nonolith/CEE/eagle/cee.brd.png

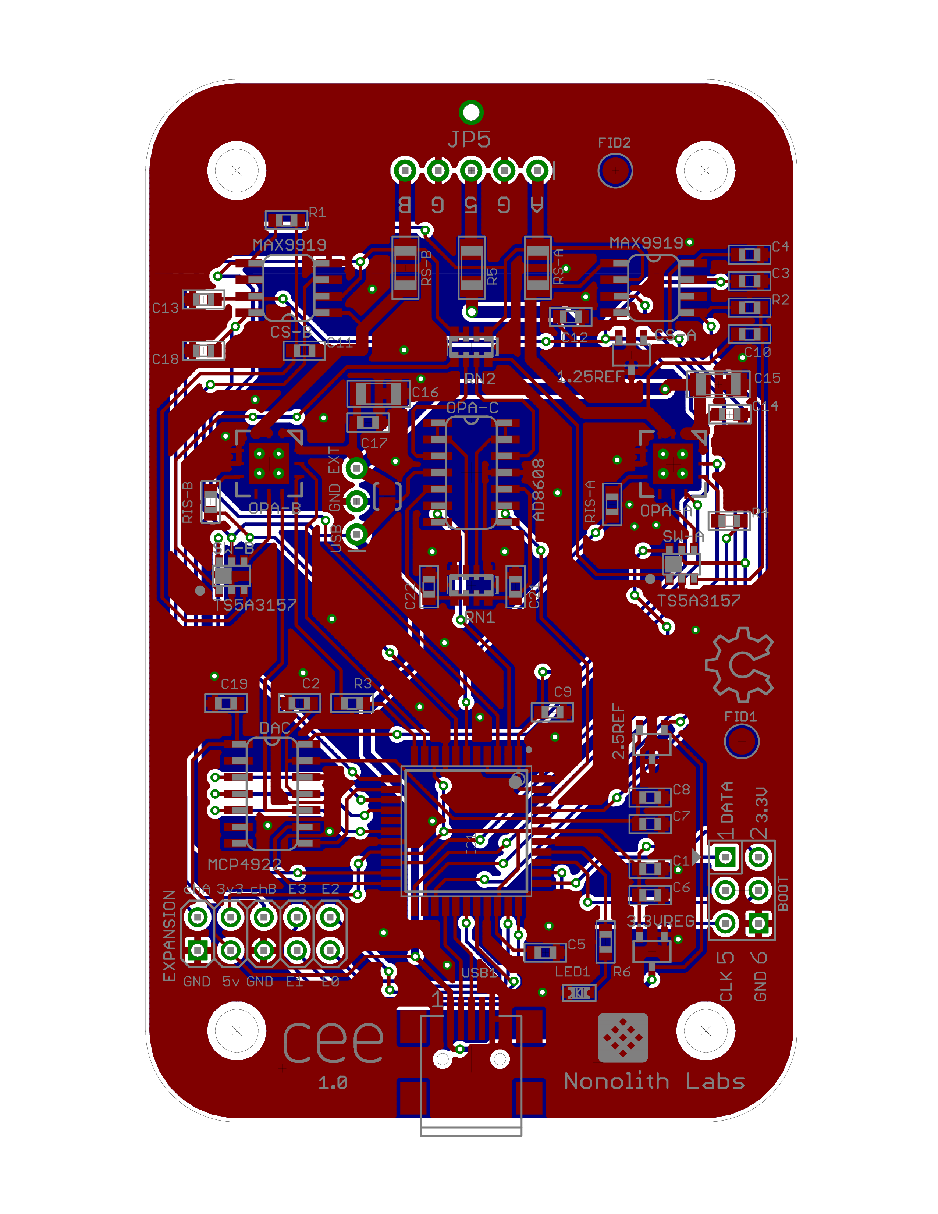
eagle/cee.brd.png
