nonolith/CEE/eagle/cee.sch.png

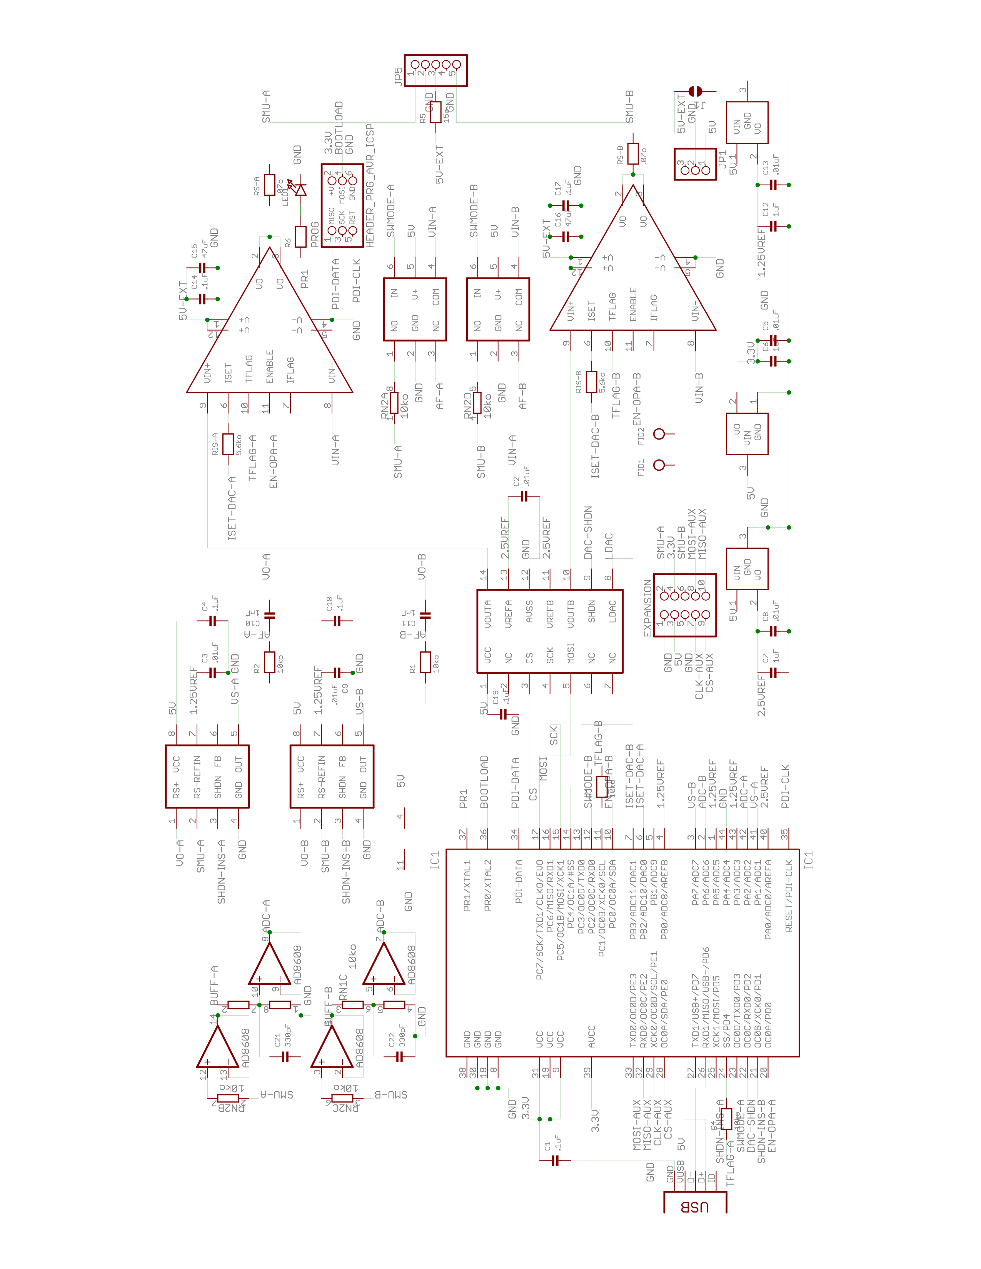
eagle/cee.sch.png
