nonolith/CEE/eagle/cee.brd.pdf

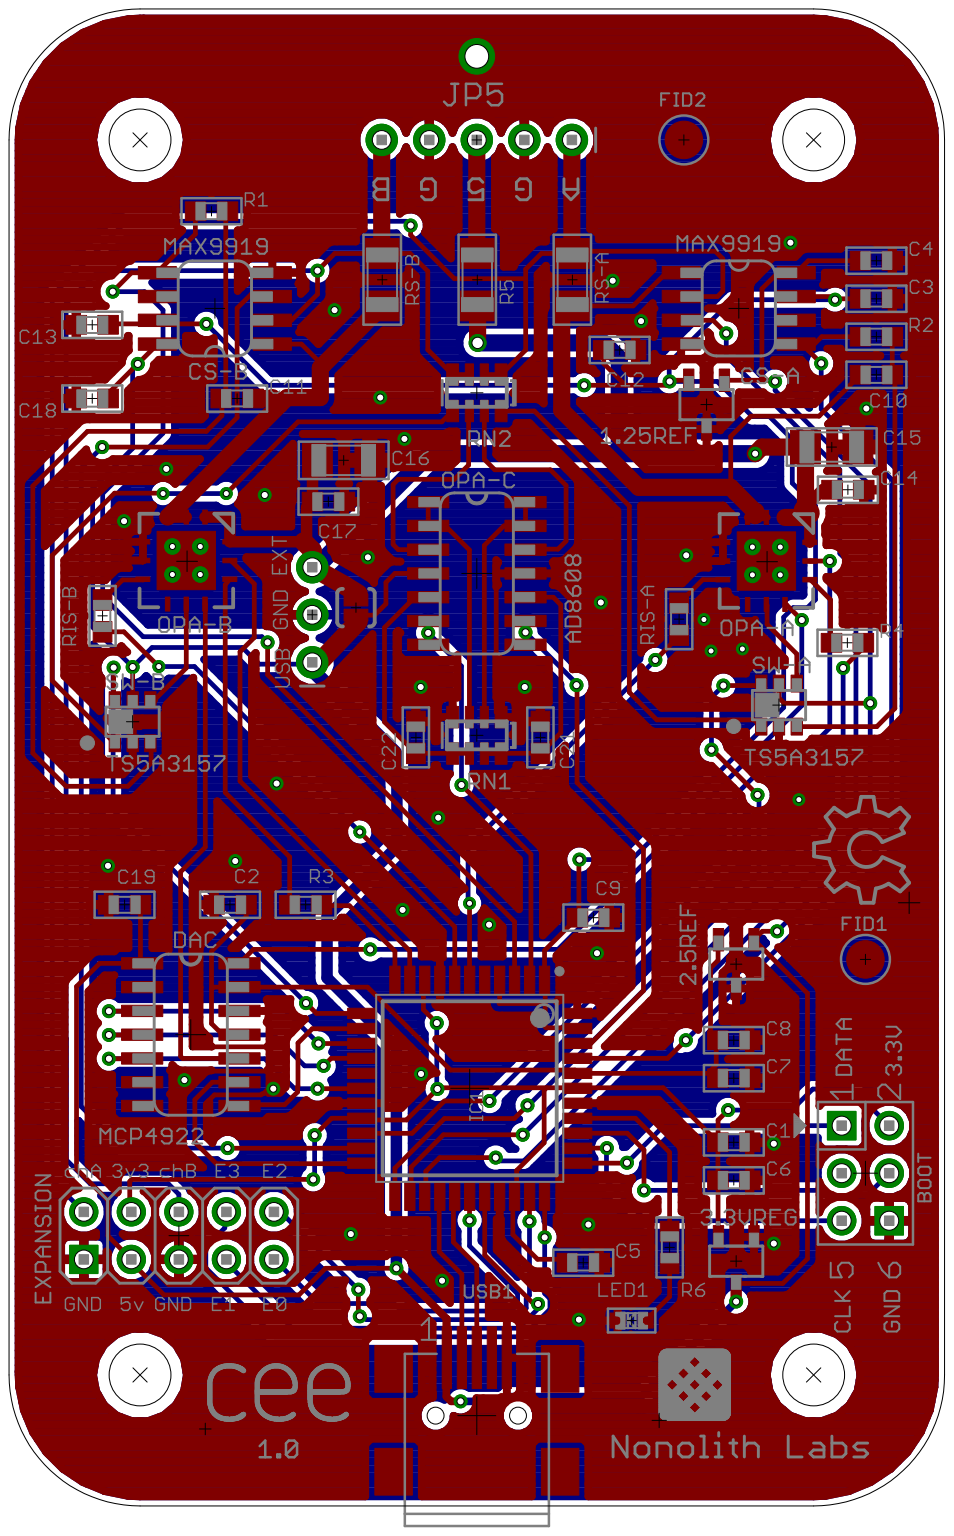
[picture p3: page 1]
