nonolith/CEE/eagle/cee.sch.pdf

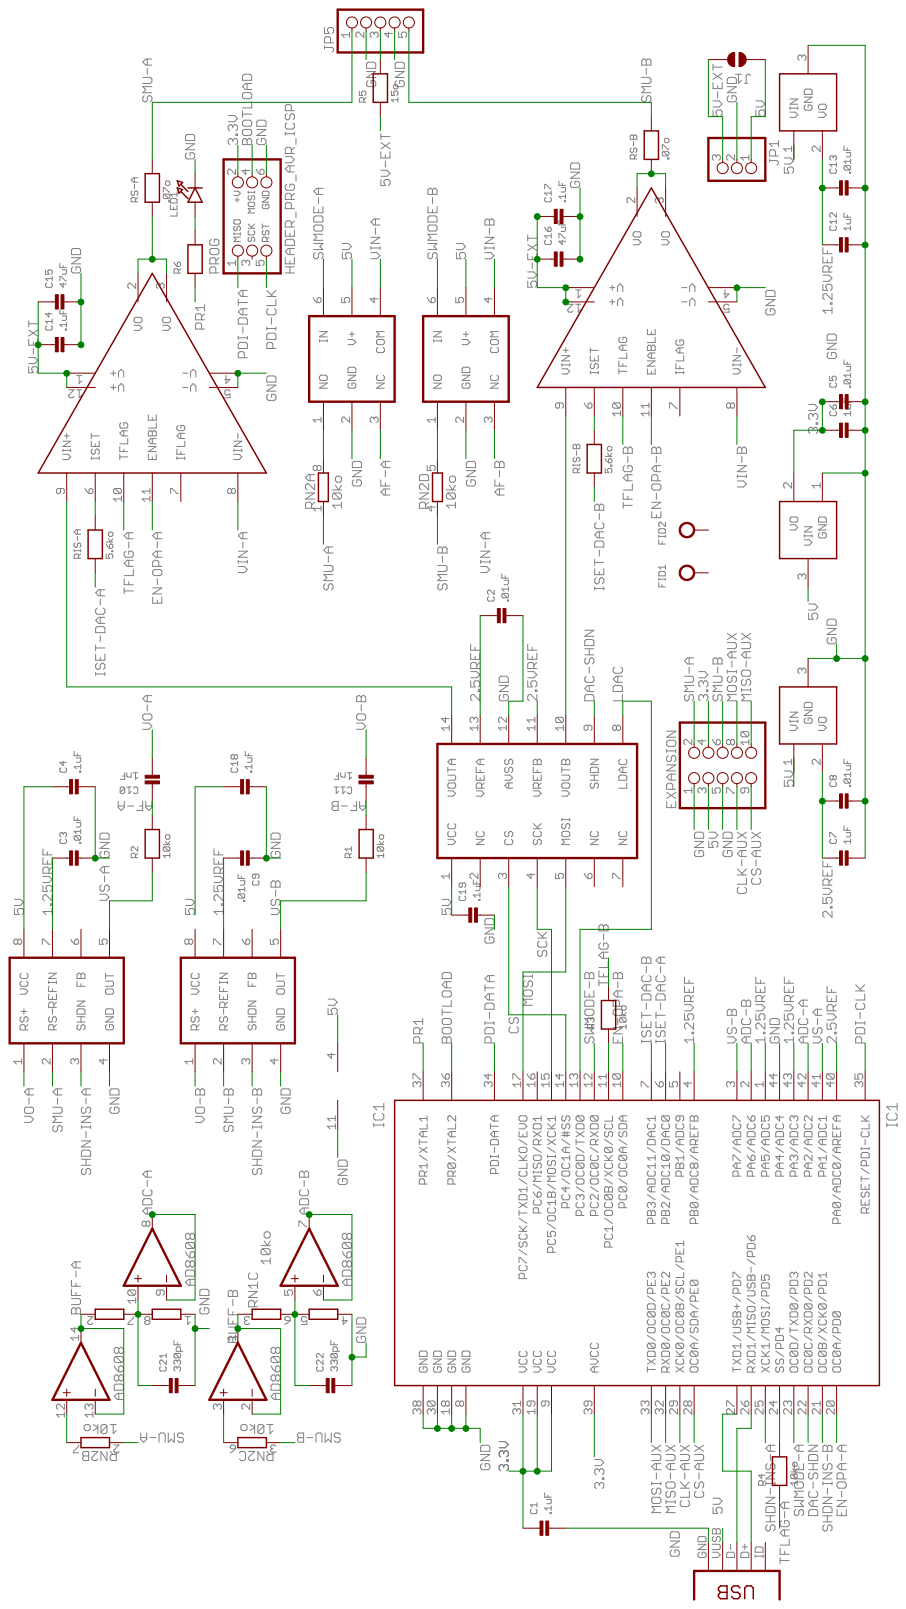
[picture p4: page 1]
