nonolith/CEE/eagle/cee.brd

## EAGLE design eagle/cee.brd (2013-06-05)

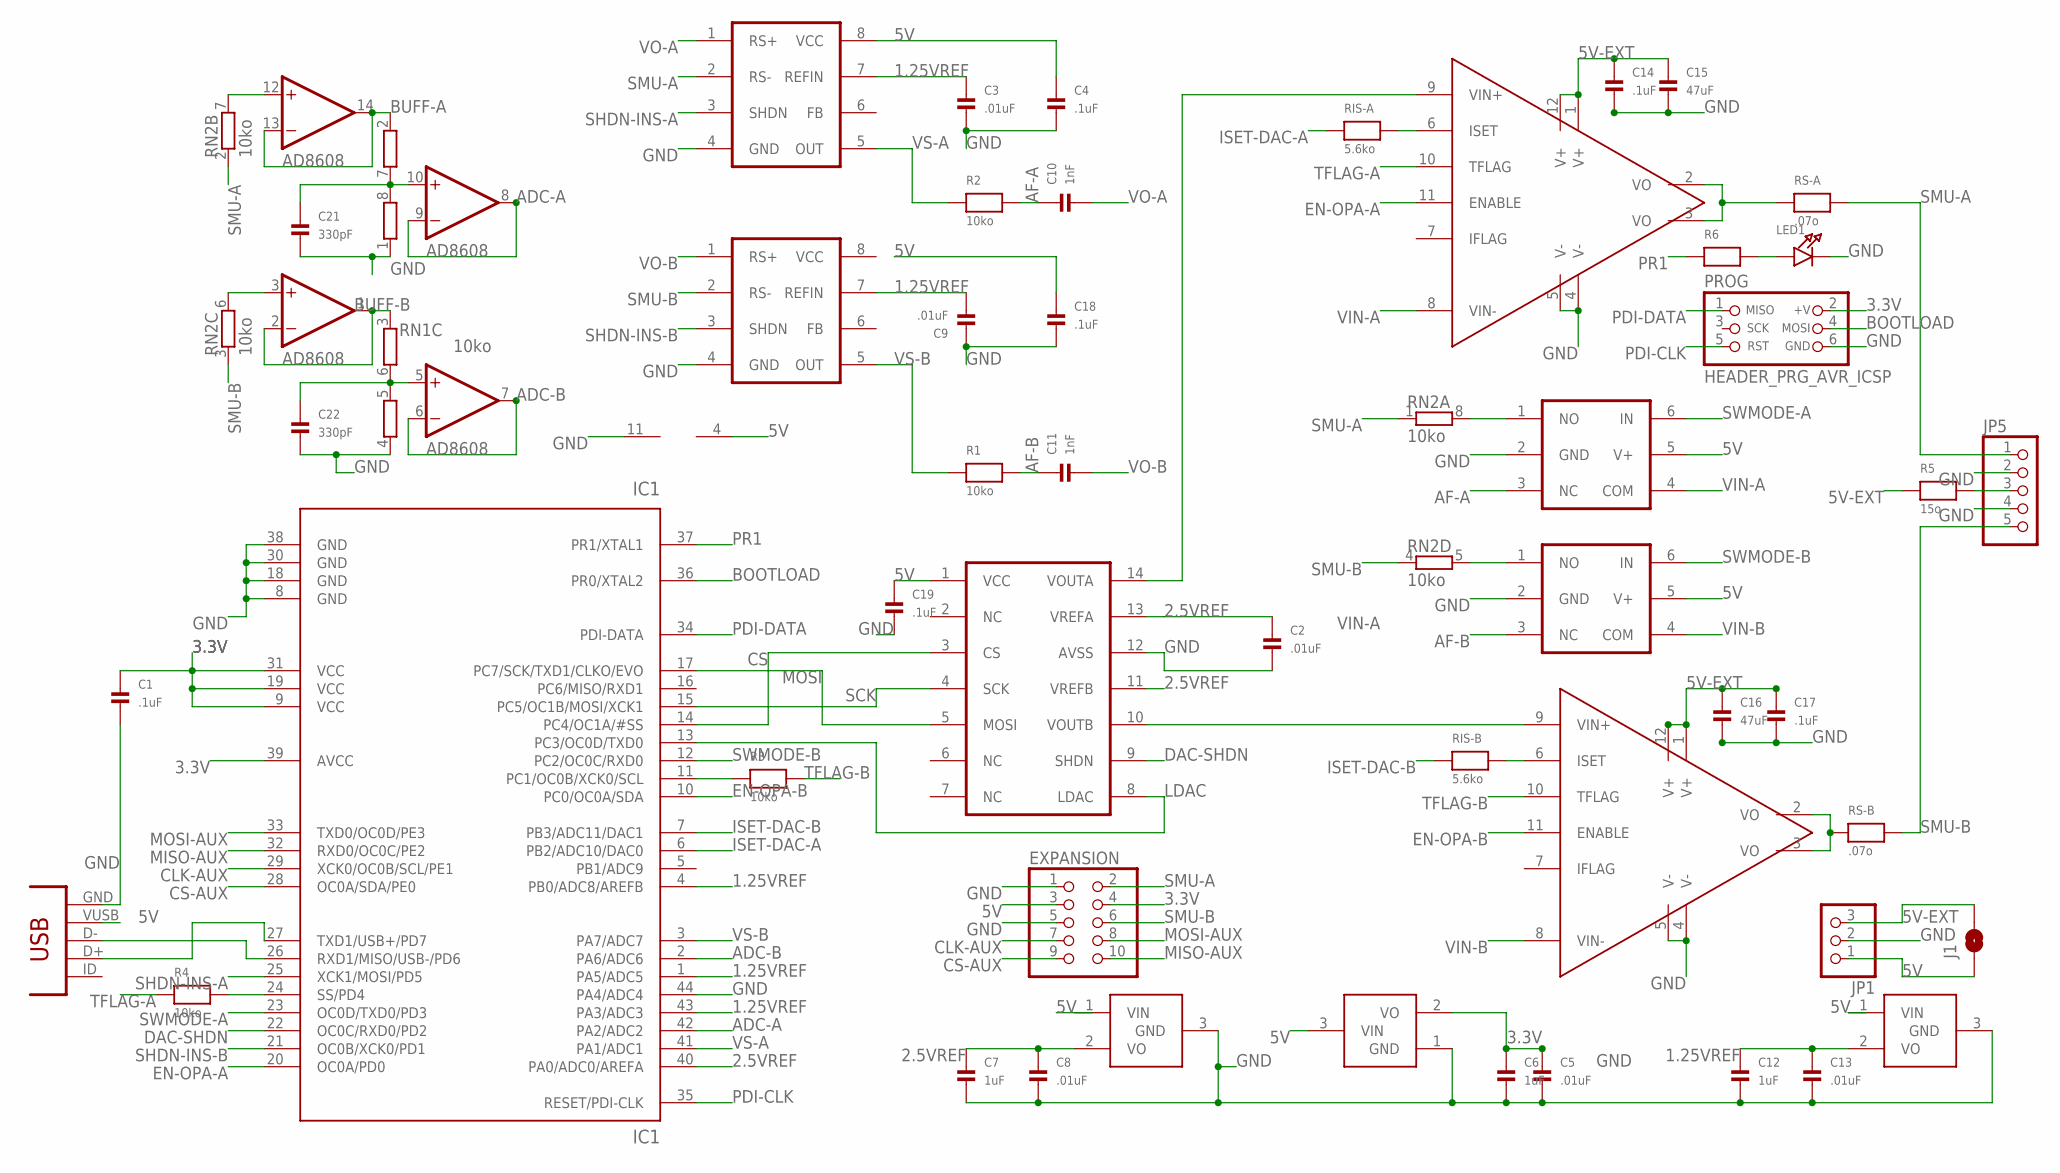
[picture p5: schematic cee.sch]

Parts:
1.25REF, 2.5REF: VREF; SOT23-3
3.3VREG: VREG; SOT23-3
C1, C4, C14, C17, C18, C19: .1uF; 0603
C2, C3, C5, C8, C9, C13: .01uF; 0603
C6, C7, C12: 1uF; 0603
C10, C11: 1nF; 0603
C15, C16: 47uF; 1206
C21, C22: 330pF; 0603
CS-A: MAX9919; SO-08
CS-B: MAX9919; SO-08
DAC: MCP4922; SO-14
EXPANSION: HEADER-2X5; 2X05
IC1: IC1; TQFP-44
J1: SOLDERJUMPERNC2; SJ_2S-NOTRACE
JP1: HEADER-1X3ROUND; 1X03_ROUND
JP5: HEADER-1X5ROUND; 1X05_ROUND
LED1: LED0603; CHIPLED_0603
OPA-A: OPA567; QFN-12
OPA-B: OPA567; QFN-12
OPA-C: AD8608; SO-14
PROG: HEADER_PRG_AVR_ICSP; HEADER_PRG_2X03
R1, R2, R3, R4: 10ko; 0603
R5: 15o; 1206
R6: RESISTOR0603; 0603
RIS-A: 5.6ko; 0603
RIS-B: 5.6ko; 0603
RN1, RN2: 10ko; RN8P-4R-CRA06S
RS-A: .07o; 1206
RS-B: .07o; 1206
SW-A: TS5A3157; SOT23-6
SW-B: TS5A3157; SOT23-6
USB1: CON-USB-MINI-BUSB1; CONN_USB_MINI-B

Connections:
1.25VREF: 1.25REF.2 (VO), C3.1, C9.2, C12.1, C13.1, CS-A.7 (REFIN), CS-B.7 (REFIN), IC1.1 (PA5/ADC5), IC1.4 (PB0/ADC8/AREFB), IC1.43 (PA3/ADC3)
2.5VREF: 2.5REF.2 (VO), C2.1, C7.1, C8.1, DAC.11 (VREFB), DAC.13 (VREFA), IC1.40 (PA0/ADC0/AREFA)
3.3V: 3.3VREG.2 (VO), C1.1, C5.1, C6.1, EXPANSION.4, IC1.9 (VCC), IC1.19 (VCC), IC1.31 (VCC), IC1.39 (AVCC), PROG.2 (+V)
5V: 1.25REF.1 (VIN), 2.5REF.1 (VIN), 3.3VREG.3 (VIN), C4.1, C18.1, C19.1, CS-A.8 (VCC), CS-B.8 (VCC), DAC.1 (VCC), EXPANSION.3, J1.1, JP1.1, OPA-C.4 (V+), SW-A.5 (V+), SW-B.5 (V+), USB1.VUSB
5V-EXT: C14.1, C15.1, C16.1, C17.1, J1.2, JP1.3, OPA-A.1 (V+), OPA-A.12 (V+), OPA-B.1 (V+), OPA-B.12 (V+), R5.1
5V-EXT-P: JP5.3, R5.2
ADC-A: IC1.42 (PA2/ADC2), OPA-C.8 (OUT), OPA-C.9 (-IN)
ADC-B: IC1.2 (PA6/ADC6), OPA-C.6 (-IN), OPA-C.7 (OUT)
AF-A: C10.1, R2.2, SW-A.3 (NC)
AF-B: C11.1, R1.2, SW-B.3 (NC)
BOOTLOAD: IC1.36 (PR0/XTAL2), PROG.4 (MOSI)
BUFF-A: OPA-C.13 (-IN), OPA-C.14 (OUT), RN1.2 (1)
BUFF-B: OPA-C.1 (OUT), OPA-C.2 (-IN), RN1.3 (1)
CLK-AUX: EXPANSION.7, IC1.29 (XCK0/OC0B/SCL/PE1)
CS: DAC.3 (CS), IC1.14 (PC4/OC1A/#SS)
CS-AUX: EXPANSION.9, IC1.28 (OC0A/SDA/PE0)
D+: IC1.27 (TXD1/USB+/PD7), USB1.D+
D-: IC1.26 (RXD1/MISO/USB-/PD6), USB1.D-
DAC-SHDN: DAC.9 (SHDN), IC1.22 (OC0C/RXD0/PD2)
EN-OPA-A: IC1.20 (OC0A/PD0), OPA-A.11 (ENABLE)
EN-OPA-B: IC1.10 (PC0/OC0A/SDA), OPA-B.11 (ENABLE)
GND: 1.25REF.3 (GND), 2.5REF.3 (GND), 3.3VREG.1 (GND), C1.2, C2.2, C3.2, C4.2, C5.2, C6.2, C7.2, C8.2, C9.1, C12.2, C13.2, C14.2, C15.2, C16.2, C17.2, C18.2, C19.2, C21.2, C22.2, CS-A.4 (GND), CS-B.4 (GND), DAC.12 (AVSS), EXPANSION.1, EXPANSION.5, IC1.8 (GND), IC1.18 (GND), IC1.30 (GND), IC1.38 (GND), IC1.44 (PA4/ADC4), JP1.2, JP5.2, JP5.4, LED1.C, OPA-A.4 (V-), OPA-A.5 (V-), OPA-B.4 (V-), OPA-B.5 (V-), OPA-C.11 (V-), PROG.6 (GND), RN1.1, RN1.4 (1), SW-A.2 (GND), SW-B.2 (GND), USB1.GND
ISET-A: OPA-A.6 (ISET), RIS-A.2
ISET-B: OPA-B.6 (ISET), RIS-B.2
ISET-DAC-A: IC1.6 (PB2/ADC10/DAC0), RIS-A.1
ISET-DAC-B: IC1.7 (PB3/ADC11/DAC1), RIS-B.1
LDAC: DAC.8 (LDAC), IC1.13 (PC3/OC0D/TXD0)
LEDR: LED1.A, R6.2
MISO-AUX: EXPANSION.10, IC1.32 (RXD0/OC0C/PE2)
MOSI: DAC.5 (MOSI), IC1.17 (PC7/SCK/TXD1/CLKO/EVO)
MOSI-AUX: EXPANSION.8, IC1.33 (TXD0/OC0D/PE3)
unnamed: C21.1, OPA-C.10 (+IN), RN1.7 (2), RN1.8 (2)
unnamed: C22.1, OPA-C.5 (+IN), RN1.5 (2), RN1.6 (2)
PDI-CLK: IC1.35 (RESET/PDI-CLK), PROG.5 (RST)
PDI-DATA: IC1.34 (PDI-DATA), PROG.1 (MISO)
PR1: IC1.37 (PR1/XTAL1), R6.1
SCK: DAC.4 (SCK), IC1.15 (PC5/OC1B/MOSI/XCK1)
SHDN-INS-A: CS-A.3 (SHDN), IC1.25 (XCK1/MOSI/PD5)
SHDN-INS-B: CS-B.3 (SHDN), IC1.21 (OC0B/XCK0/PD1)
SMU-A: CS-A.2 (RS-), EXPANSION.2, JP5.1, RN2.1, RN2.2 (1), RS-A.2
SMU-B: CS-B.2 (RS-), EXPANSION.6, JP5.5, RN2.3 (1), RN2.4 (1), RS-B.2
SMUP-A: OPA-C.12 (+IN), RN2.7 (2)
SMUP-B: OPA-C.3 (+IN), RN2.6 (2)
SMUP-SW-A: RN2.8 (2), SW-A.1 (NO)
SMUP-SW-B: RN2.5 (2), SW-B.1 (NO)
SWMODE-A: IC1.23 (OC0D/TXD0/PD3), SW-A.6 (IN)
SWMODE-B: IC1.12 (PC2/OC0C/RXD0), SW-B.6 (IN)
TFLAG-A: OPA-A.10 (TFLAG), R4.1
TFLAG-B: OPA-B.10 (TFLAG), R3.2
TFLAGP-A: IC1.24 (SS/PD4), R4.2
TFLAGP-B: IC1.11 (PC1/OC0B/XCK0/SCL), R3.1
VIN-A: OPA-A.8 (VIN-), SW-A.4 (COM)
VIN-B: OPA-B.8 (VIN-), SW-B.4 (COM)
VO-A: C10.2, CS-A.1 (RS+), OPA-A.2 (VO), OPA-A.3 (VO), RS-A.1
VO-B: C11.2, CS-B.1 (RS+), OPA-B.2 (VO), OPA-B.3 (VO), RS-B.1
VOUT-A: DAC.14 (VOUTA), OPA-A.9 (VIN+)
VOUT-B: DAC.10 (VOUTB), OPA-B.9 (VIN+)
VS-A: CS-A.5 (OUT), IC1.41 (PA1/ADC1), R2.1
VS-B: CS-B.5 (OUT), IC1.3 (PA7/ADC7), R1.1

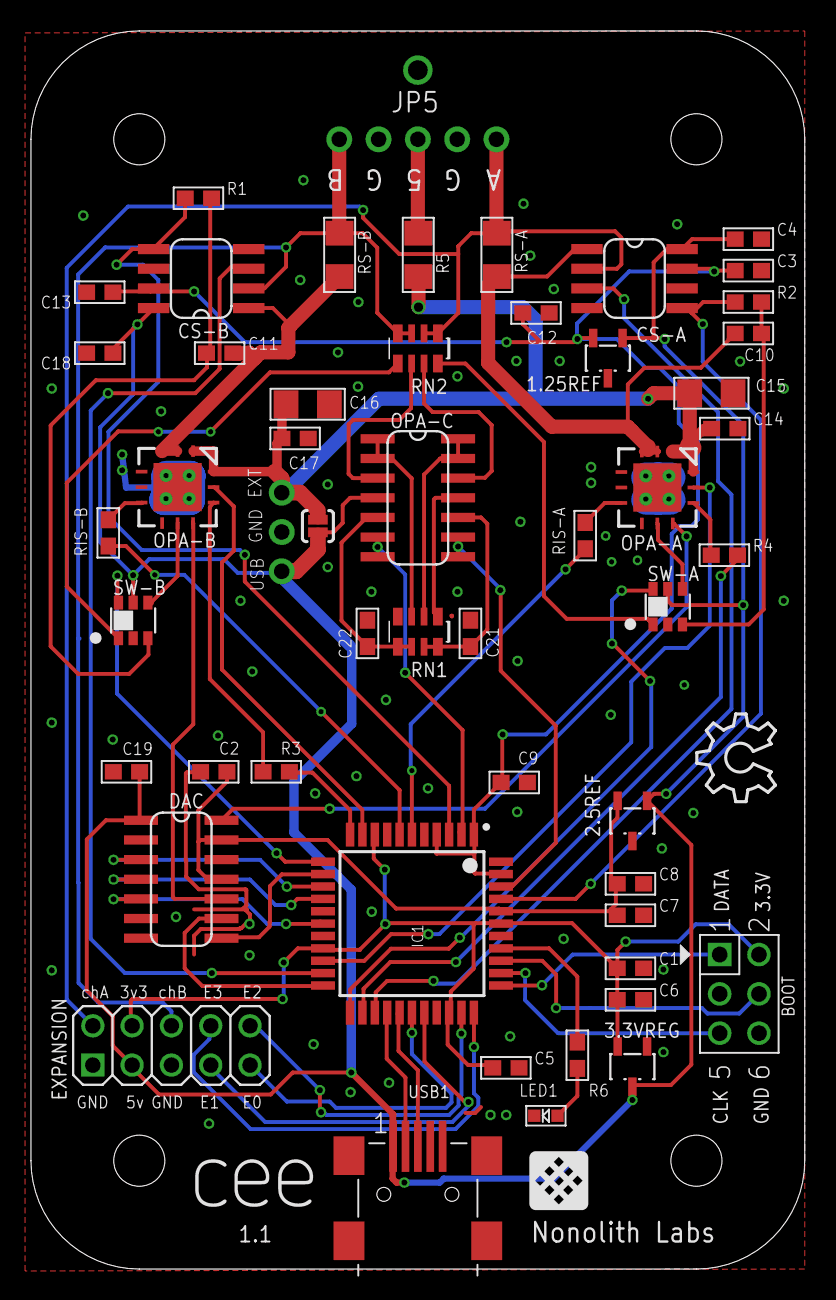
[picture p6: board cee.brd from above]

Board: 2 copper layers, 50.0 x 80.0 mm, 59 parts (0 on the bottom side), 59 nets.

Other parts of the board:
U$1: OSHW_8X200_NOTEXT
U$2: LOGO_CEE
U$3: LOGO_NONOLITH
U$8, U$9, U$10, U$11: STAND-OFF
