nonolith/CEE/(commit log)

2011-06-30 initial commit of eagle files for schematic test board
    [CEE-devboard.brd, CEE-devboard.sch]
2011-07-01 Add simplified schematic
2011-07-05 added BOM, exported from google docs.
2011-07-06 reformatted git repository, added pre-alpha EAGLE files for fully integrated board
    [devCEE.brd, devCEE.sch, integratedCEE.brd, integratedCEE.sch]
2011-07-10 added labels to all nets
    [devCEE.sch]
2011-07-19 extended pads on qfn12/opa567 by .2mm
2011-07-21 added rework of schematic featuring atxmega32a4u as primary micro. not yet complete, but all major chips are in place.
    [rehash.sch]
2011-07-21 more wires and netlabels. missing opamp buffer and vref
    [rehash.sch]
2011-07-21 decoupled, vref'ed, vcc'ed
    [rehash.sch]
2011-07-21 pretty close to done. opamp filter/adc buffers added, reference/regulator pinouts updated.
    [rehash.sch]
2011-07-22 removed old eagle files based on h-bridge switching and lpc1343
    [devCEE.brd, devCEE.sch, integratedCEE.brd, integratedCEE.sch]
2011-07-22 renamed rehash.sch to reflect relationship to bom
    [v3.sch]
2011-07-22 added iset resistors on opa-a and opa-b
    [v3.sch]
2011-07-22 added resistor values for RIS-A/B
    [v3.sch]
2011-07-22 added pdf. few small changes.
    [v3.sch]
2011-07-22 128 airwires to go...
    [v3.brd, v3.sch]
2011-07-25 added resistor values for INA2332 gainset
    [v3.sch]
2011-07-26 reworked wires, leaving vrefb open
    [v3.brd, v3.sch]
2011-07-29 replaced INA2332 with dual MAX9919/20
    [v3.brd, v3.sch]
2011-07-29 added ad8606 2chan opamp, reworked schem to reflect recent part decisions
    [v3.brd, v3.sch]
2011-07-29 oops, had an extra 2.5VREF instead of a 1.25VREF
    [v3.brd, v3.sch]
2011-07-29 added power connections to AD8606.
    [v3.brd, v3.sch]
2011-07-29 Rearrange ADC inputs for optimal use of XMEGA PGA
    [v3.brd, v3.sch]
2011-07-29 update simplified schematic
2011-07-29 Add protection resistors
    [v3.brd, v3.sch]
2011-07-29 removed BOM.pdf in favor of bit.ly/CEEBOM
2011-07-29 reworked DAC SPI connection to avoid potential RXD/CS conflict
    [v3.brd, v3.sch]
2011-07-29 added link to BOM in readme.mkd
2011-08-01 Board boundaries and mounting holes
    [v3.brd, v3.sch]
2011-08-03 placed passives, added arrays, reduced size
    [v3.brd, v3.sch]
2011-08-03 Ground fill
    [v3.brd]
2011-08-07 more layout, rm'ed gainset from max9919
    [v3.brd, v3.sch]
2011-08-07 Rearrange components for better routing
    [v3.brd, v3.sch]
2011-08-07 Start routing
    [v3.brd, v3.sch]
2011-08-07 more routing
    [v3.brd, v3.sch]
2011-08-07 added TS5A3157; single SPDT switch in SOT23
2011-08-07 replaced dual SPDT switch with a pair of single SPDT switches, increasing ease of routing.
    [v3.brd, v3.sch]
2011-08-07 GND and 5V routes
    [v3.brd]
2011-08-08 Routed + DRC pass
    [v3.brd]
2011-08-08 optimizations and extra caps on the opa567
    [v3.brd, v3.sch]
2011-08-08 Adjust ground planes
    [v3.brd, v3.sch]
2011-08-08 rehashed silkscreens, made a few random changes, added up-to-date images for brd and sch
    [v3.brd, v3.sch]
2011-08-08 Add to silkscreen, update board images
    [v3.brd, v3.sch]
2011-08-08 12mil ground plane clearance, tented vias
    [v3.brd]
2011-08-09 Header positioning; via tweaks
    [v3.brd]
2011-08-09 sync board to lib
    [v3.brd, v3.sch]
2011-08-09 Rework pins for better layout
    [v3.brd]
2011-08-09 Improve ground plane
    [v3.brd, v3.sch]
2011-08-09 DRC fix
    [v3.brd]
2011-08-09 grounding tweaks
    [v3.brd]
2011-08-10 1.25VREF to REFB
    [v3.brd, v3.sch]
2011-08-10 Rearrange ADC pins for more flexibility in ADC config
    [v3.brd, v3.sch]
2011-08-11 Clean up traces
    [v3.brd]
2011-08-12 fix 0-length airwire
    [v3.brd]
2011-08-12 8mil spacing, more OCD about trace angle
    [v3.brd]
2011-08-12 Split external 5V rail
    [v3.brd, v3.sch]
2011-08-12 Clean up silkscreen
    [v3.brd, v3.sch]
2011-08-12 MAX9919 decoupling caps
    [v3.brd, v3.sch]
2011-08-13 small board mods; increased trace spacing and width
    [v3.brd]
2011-08-13 increase 5v-EXT trace width
    [v3.brd]
2011-10-04 added correct function prototype for writeDAC
2011-10-05 calling it a night. DAC control is pretty much fail at the moment, but the pieces should be in place
    [vendorReqTest.py]
2011-10-06 Fix DAC SPI. - Configure 1MHz baud rate - Clear TX complete flag before using it - Mask and pack data correctly
2011-10-06 added channel config/write code based off schematic
2011-10-06 setting current/voltage is working! :D
2011-10-07 cleaned code, fixed iset function
    [vendorReqCtrl.py]
2011-10-08 sequential handling of ADCA.CH0 works - virtual channels were broken
    [vendorReqCtrl.py]
2011-10-08 Convert binary ADC data to V and A
2011-10-08 commented readADC to clarify pin/info mappings
2011-10-10 changed ADC to differential mode for great justice
2011-10-10 added offset removal function for better accuracy. switched ADC ground from external to internal for higher precision
2011-10-10 firmware/update.py: don't print error message when the device is already in bootloader mode
2011-10-12 replaced busyloop ADC code with dysfunctional freerun code
2011-10-13 fixed issues with schematic
    [v3.brd, v3.sch]
2011-10-14 changed DAC to SOIC
    [v3.brd, v3.sch]
2011-10-15 centered the package QFN12 and updated the v3.brd and v3.sch accordingly
    [v3.brd, v3.sch]
2011-10-16 reworked several traces - need to fix SMU-B to ADC-B and DAC routing. can't wait for vdiffs enabled via .brd/.sch as xml files...
    [v3.brd]
2011-10-16 Update library - split parts for VREG/VREF with correct pinouts for MCP1700/MAX6103. Update schematic to match
    [v3.brd, v3.sch]
2011-10-16 Route SOIC DAC
    [v3.brd]
2011-10-16 fully routed - extensive fixes of analog frontend and voltage regulators. TODO: silkscreen, DRC
    [v3.brd, v3.sch]
2011-10-17 made all decoupling capacitors horizontal for simple placement
    [v3.brd]
2011-10-17 added RC series circuit providing a higher-bw path in series with MAX9919
    [v3.brd, v3.sch]
2011-10-17 fixed DRC except for opa567 errors and 'drill size' errors.
    [v3.brd]
2011-10-17 Update current feedback filtering - resistor goes in series with feedback; route these areas more efficiently
    [v3.brd, v3.sch]
2011-10-17 Clean up minor zigzags in traces
    [v3.brd]
2011-10-17 Clean up traces and silkscreen
    [v3.brd]
2011-10-17 moved programming header from awkward five-pin to kosher six-pin (2x3)
    [v3.brd, v3.sch]
2011-10-17 updated board and library with [hopefully] visible silkscreen dot indicating switch orientation
    [v3.brd, v3.sch]
2011-10-17 added orientation indicator to SO-14, updated board accordingly
    [v3.brd, v3.sch]
2011-10-17 moved parts and polygons to have a 50 by 80 profile
    [v3.brd]
2011-10-18 added protection resistors on TFLAGs and on switch inputs
    [v3.brd, v3.sch]
2011-10-18 s/Nonolith Labs/NonolithLabs.com/ and added OSHW logo
    [v3.brd]
2011-10-19 Align traces, clean up. library: remove holes from USB footprint
    [v3.brd, v3.sch]
2011-10-19 Add decoupling caps on 5v rail for DAC and opamp
    [v3.brd, v3.sch]
2011-10-19 Add silkscreen labels for PDI connector
    [v3.brd]
2011-10-19 Add silkscreen labels for expansion header
    [v3.brd]
2011-10-19 Add logos
    [v3.brd, v3.sch]
2011-10-19 Align logos
    [v3.brd]
2011-10-19 Working ADC IN streaming
2011-10-19 added 1x2 .1" header as testpoints on D+ and D- giving us a push-and-play test connection
    [v3.brd, v3.sch]
2011-10-24 Fix ground plane near VOUT-A via
    [v3.brd]
2011-10-25 added lowpass cap on voltage divider for SMUA/B sense
    [v3.brd, v3.sch]
2011-10-25 place capacitors symmetrically
    [v3.brd]
2011-10-25 changed all vias to 15mil drill
    [v3.brd]
2011-10-26 added images of the new PCB in png and pdf
2011-10-27 s/sampleIndex/inSampleIndex/ to clear up variable naming conventions when dealing with bidirectional packets
2011-10-28 removed LDAC strobing. function identical to old code, but exact behaviour easier to port to interrupts.
2011-10-28 fixed a ton of easy errors - lots of problems with syntax and poorly formed / absent prototypes
2011-10-29 Streaming working with interrupts
2011-10-29 Increase SPI clock
2011-10-29 SPI output looks ok...at 10ksps
2011-10-30 DAC SPI: clear TXCIF after enabling TXC to avoid race condition
2011-11-01 reorganized eagle/, moving the library to its own repo, and eliminating v3/ in favor of a files in eagle/
    [v3.brd, v3.sch]
2011-11-08 cleanup cleanup
    [v3.brd, v3.sch]
2011-11-08 added values to a few components, rm'ed nonolith.lbr
    [v3.brd, v3.sch]
2011-11-08 die, old library, die.
2011-11-10 added early-stage support for the xmega's internal gain
2011-11-11 Add case design
2011-11-15 added current control via DACB / ISETAB
2011-11-17 went from ad8606 to ad8608 for full input buffering
    [v3.brd, v3.sch]
2011-11-17 routed DACA / DACB to ISETA/ISETB
    [v3.brd, v3.sch]
2011-11-17 further cleanup of schematic - assigned values to parts, changed linewidth, added labels.
    [v3.brd, v3.sch]
2011-11-17 moved 1x3 and 1x4 headers from SFE library to Nonolith library
    [v3.brd, v3.sch]
2011-11-17 standardized value formats
    [v3.brd, v3.sch]
2011-11-17 added values for antialiasing caps, added second resistor network for protection
    [v3.brd, v3.sch]
2011-11-17 moved via, fixed solder bridge
    [v3.brd, v3.sch]
2011-11-17 Seeed DRC checks out
    [v3.brd]
2011-11-18 moved 5V supply to center pin on main output header, included 1206 pad for protection resistor, cleaned up silkscreen
    [v3.brd, v3.sch]
2011-11-19 moved output jack to lie flush with edge of PCB
    [v3.brd]
2011-11-19 clean up / organize schematics and export binaries
    [v3.sch]
2011-11-19 that was almost bad. had a ground via going through a power trace...
    [v3.brd]
2011-11-19 cleaned up output port silkscreen
    [v3.brd]
2011-11-19 clean up routing
    [v3.brd]
2011-11-19 add 200mA current limit reflecting shippable product
2011-11-20 Position header such that it lines up with the edge of the case. Fix silkscreen.
    [v3.brd]
2011-11-20 Rotate silkscreen on output pins
    [v3.brd]
2011-11-20 Standardize silkscreen font for component labels: 35mil, 12%, vector
    [v3.brd, v3.sch]
2011-11-20 cleaned up silkscreen with readable part numbers
    [v3.brd, v3.sch]
2011-11-20 tweak label positioning
    [v3.brd]
2011-11-20 5V supply to 3.3VREG fixed. DRC check OK.
    [v3.brd, v3.sch]
2011-11-20 added binaries of the board
2011-11-20 Move RN1 down for easier soldering
    [v3.brd]
2011-11-20 reposition a few vias and labels
    [v3.brd]
2011-11-22 fixed hole dimensions, moved from svg w/ inkscape + sodipodi namespaces to 'plain' svg
2011-11-23 fixed(?) hole spacing
2011-11-23 Fix case
2011-11-23 Add dimensioned CEE case. Save ceeCase.svg as standard svg
2011-11-23 updated to match d22de80 in Nonolith-Eagle-Library
    [v3.brd]
2011-11-27 added silkscreen for JP5 / output header
    [v3.brd]
2011-11-30 Add notch for USB cable clearance
2011-12-01 added values for R5, C21, and C22
    [v3.brd, v3.sch]
2011-12-02 added support for channel-specific current limits
2011-12-03 Fix IN_sample packing (readADC).
    The ADC sign-extends negative numbers, so an &0x0f is necessary
    when packing as 12b.
2011-12-05 removed problematic 1x2 header from under miniusb connector, moved output connecter up 2mm
    [v3.brd, v3.sch]
2011-12-05 added fids by OSHW logo and output header
    [v3.brd, v3.sch]
2011-12-05 added second GND connection to expansion header, replacing NC with something useful
    [v3.brd, v3.sch]
2011-12-05 cleaned up 5V trace under miniusb connector
    [v3.brd]
2011-12-06 put case files in their own folder
2011-12-06 removed simplified schematic. it needs to be rebuilt to update and needs to be designed to actually explain things to people who don't know the characteristics of an ideal volt/amp meter
2011-12-09 moved to miniusb-b connector with positioning posts. props to dproto for the part & protip.
    [v3.brd, v3.sch]
2011-12-10 reworked traces and vias central to miniusb connector
    [v3.brd]
2011-12-11 added blinkenlight to PR1, cleaned up silkscreen (30/12%/Vect)
    [v3.brd, v3.sch]
2011-12-20 s/1.0 RC3/1.0/
    [v3.brd]
2011-12-20 s/.01uF/1nF/, export up-to-date binary images
    [v3.brd, v3.sch]
2012-01-04 add LED behavior - blink 50ms on power, then indicate USB bulk streaming
2012-01-11 renamed eagle files
    [cee.brd, cee.sch]
2012-01-11 updated case CAD
2013-05-31 Add Bill of Materials (As manufactured on V1.0)
2013-06-05 Upgrade to Eagle 6 XML format
    [cee.brd, cee.sch]
2013-06-05 Update silkscreen: * Version 1.1 * Reposition logos * Remove fiducials
    [cee.brd, cee.sch]
2013-06-05 Add more GND plane stitching
    [cee.brd]
2013-06-27 Update BOM.mkd to match v1.1 mfctr run.
